GGPS4/halo/pcb/out/preview-both.png

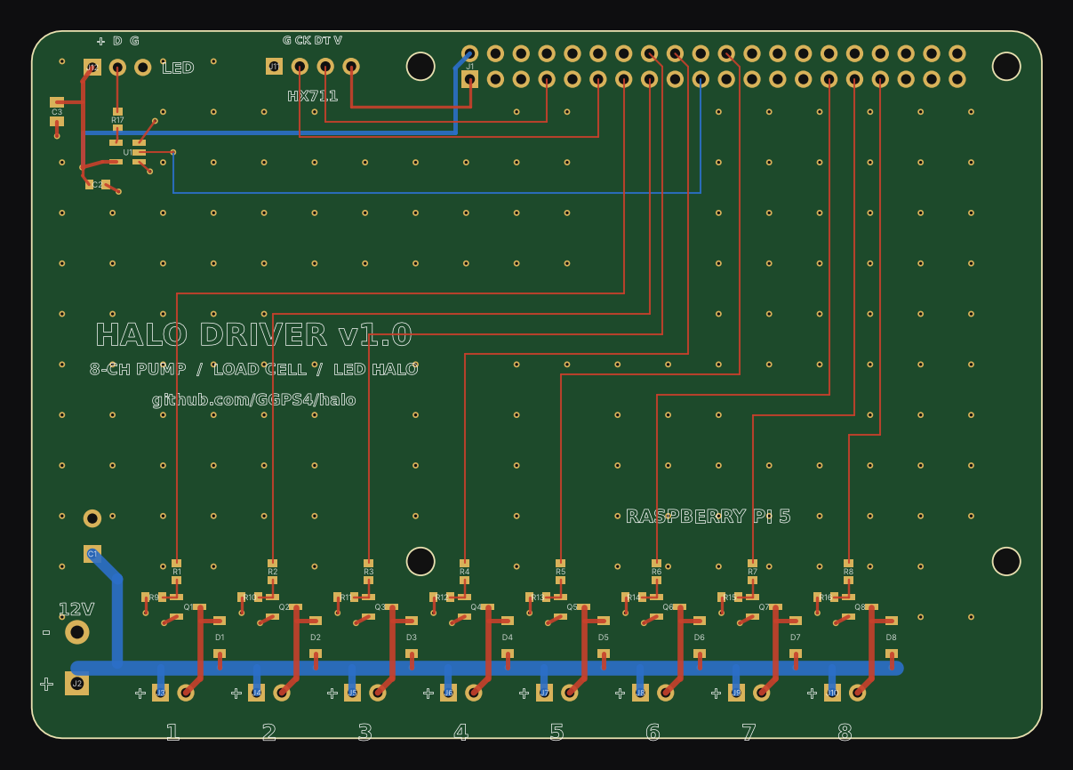
pcb/out/preview-both.png
