GGPS4/halo/pcb/out/preview-bottom.png

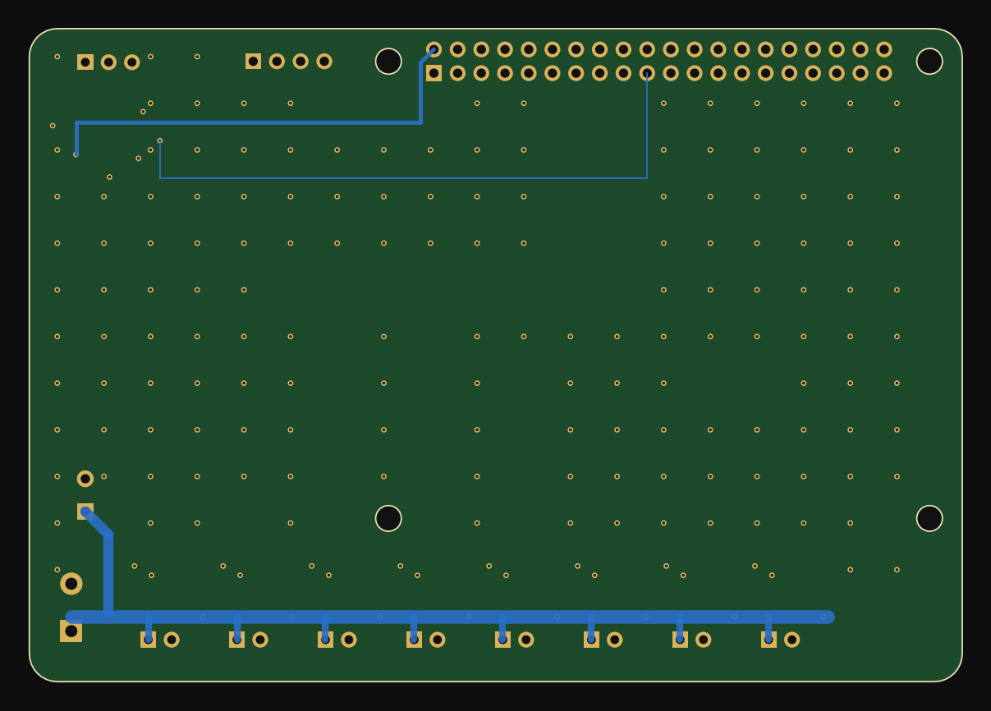
pcb/out/preview-bottom.png
