GGPS4/halo/pcb/out/halo-driver-BOM.csv

Comment | Designator | Footprint | LCSC Part #
AO3400A | Q1,Q2,Q3,Q4,Q5,Q6,Q7,Q8 | SOT-23 | C20917
B5819W | D1,D2,D3,D4,D5,D6,D7,D8 | D_SOD-123 | C8598
100 | R1,R2,R3,R4,R5,R6,R7,R8 | R_0603 | C22775
10k | R9,R10,R11,R12,R13,R14,R15,R16 | R_0603 | C25804
74AHCT1G125 | U1 | SOT-23-5 | C7484
330 | R17 | R_0603 | C23138
10uF 25V | C3 | C_0805 | C15850
100nF | C2 | C_0603 | C14663
