GGPS4/halo/pcb/out/halo-driver-hand-solder.csv

Ref | Part | Footprint
J1 | 2x20 female header | PinSocket_2x20_P2.54
J2 | 12V IN KF301-2P | TerminalBlock_5.08_1x02
C1 | 470uF 25V | CP_Radial_D8.0mm_P3.50mm
J3 | PUMP 1 JST-XH | JST_XH_B2B-XH-A
J4 | PUMP 2 JST-XH | JST_XH_B2B-XH-A
J5 | PUMP 3 JST-XH | JST_XH_B2B-XH-A
J6 | PUMP 4 JST-XH | JST_XH_B2B-XH-A
J7 | PUMP 5 JST-XH | JST_XH_B2B-XH-A
J8 | PUMP 6 JST-XH | JST_XH_B2B-XH-A
J9 | PUMP 7 JST-XH | JST_XH_B2B-XH-A
J10 | PUMP 8 JST-XH | JST_XH_B2B-XH-A
J11 | HX711 1x4 | PinHeader_1x04_P2.54
J12 | LED RING JST-XH 3P | JST_XH_B3B-XH-A
