GGPS4/halo/docs/img/wiring.png

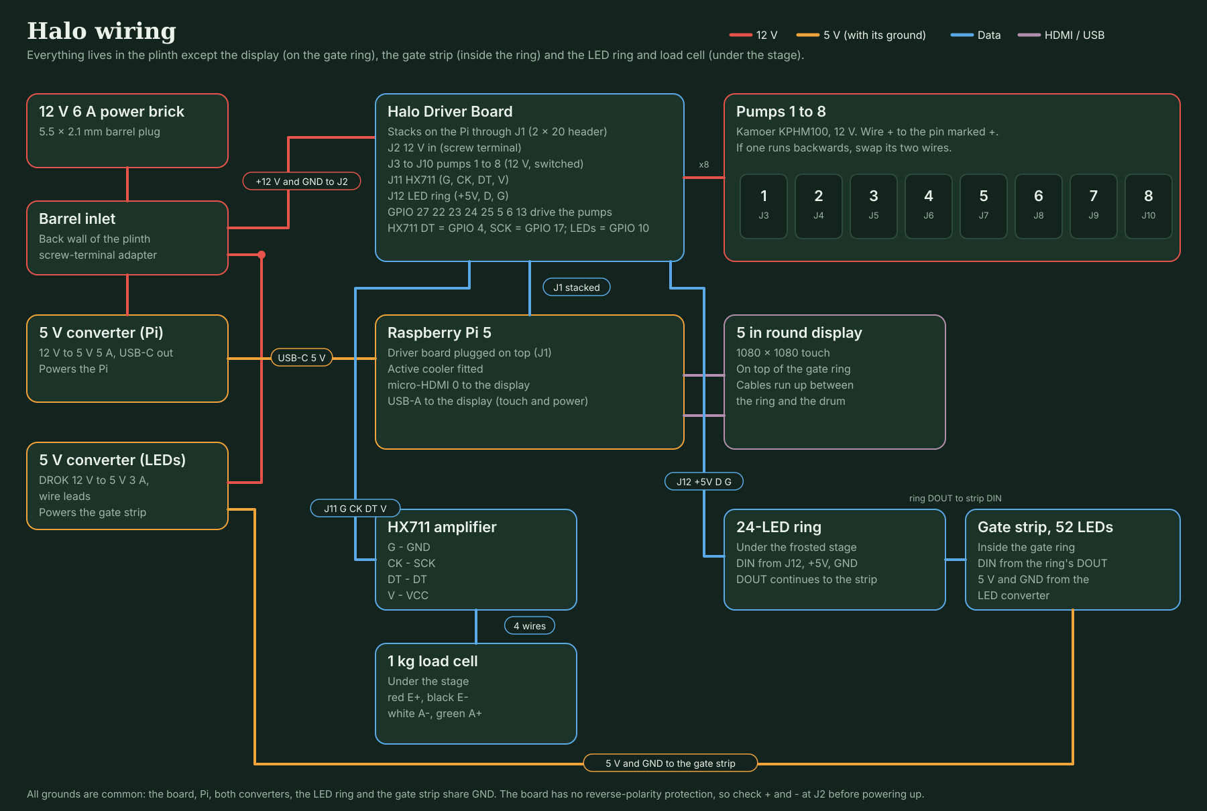
docs/img/wiring.png
