GGPS4/halo/pcb/out/halo-driver.kicad_pcb

## KiCad design pcb/out/halo-driver.kicad_pcb (2026-11-11)

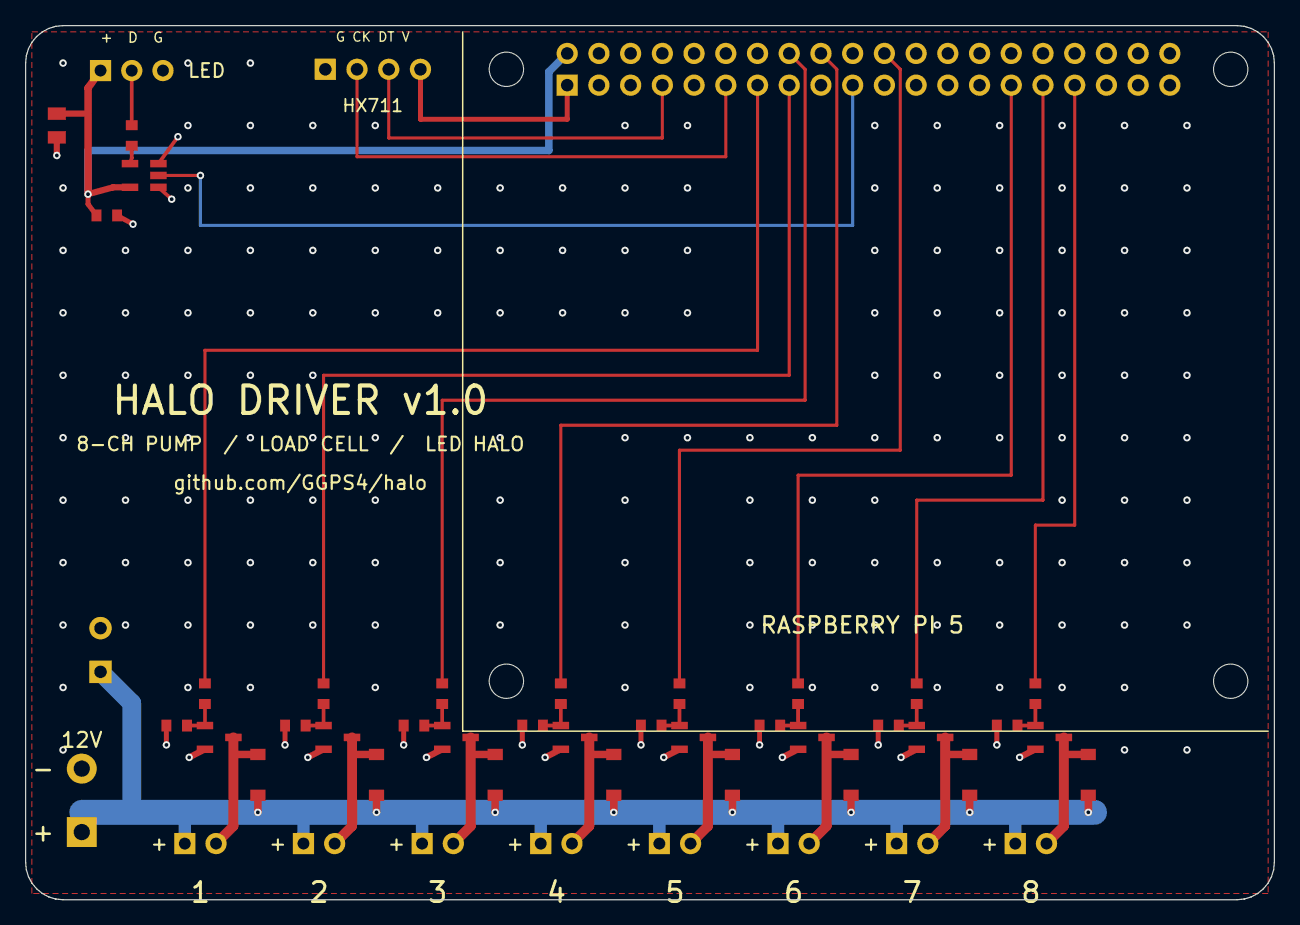
[picture p6: board halo-driver.kicad_pcb from above]

Board: 2 copper layers, 100.0 x 70.0 mm, 53 parts (0 on the bottom side), 33 nets.

Parts:
C1: 470uF 25V; CP_Radial_D8.0mm_P3.50mm
C2: 100nF; C_0603
C3: 10uF 25V; C_0805
D1, D2, D3, D4, D5, D6, D7, D8: B5819W; D_SOD-123
H1, H2, H3, H4: MountingHole_2.7mm
J1: 2x20 female header; PinSocket_2x20_P2.54
J2: 12V IN KF301-2P; TerminalBlock_5.08_1x02
J3: PUMP 1 JST-XH; JST_XH_B2B-XH-A
J4: PUMP 2 JST-XH; JST_XH_B2B-XH-A
J5: PUMP 3 JST-XH; JST_XH_B2B-XH-A
J6: PUMP 4 JST-XH; JST_XH_B2B-XH-A
J7: PUMP 5 JST-XH; JST_XH_B2B-XH-A
J8: PUMP 6 JST-XH; JST_XH_B2B-XH-A
J9: PUMP 7 JST-XH; JST_XH_B2B-XH-A
J10: PUMP 8 JST-XH; JST_XH_B2B-XH-A
J11: HX711 1x4; PinHeader_1x04_P2.54
J12: LED RING JST-XH 3P; JST_XH_B3B-XH-A
Q1, Q2, Q3, Q4, Q5, Q6, Q7, Q8: AO3400A; SOT-23
R1, R2, R3, R4, R5, R6, R7, R8: 100; R_0603
R9, R10, R11, R12, R13, R14, R15, R16: 10k; R_0603
R17: 330; R_0603
U1: 74AHCT1G125; SOT-23-5

Connections:
+3V3: J1.1, J11.4
+5V: C2.1, C3.1, J1.2, J12.1, U1.5
+12V: C1.1, D1.1, D2.1, D3.1, D4.1, D5.1, D6.1, D7.1, D8.1, J2.1, J3.1, J4.1, J5.1, J6.1, J7.1, J8.1, J9.1, J10.1
GATE1: Q1.1, R1.2, R9.2
GATE2: Q2.1, R2.2, R10.2
GATE3: Q3.1, R3.2, R11.2
GATE4: Q4.1, R4.2, R12.2
GATE5: Q5.1, R5.2, R13.2
GATE6: Q6.1, R6.2, R14.2
GATE7: Q7.1, R7.2, R15.2
GATE8: Q8.1, R8.2, R16.2
GND: C1.2, C2.2, C3.2, J1.6, J1.9, J1.14, J1.20, J1.25, J1.30, J1.34, J1.39, J2.2, J11.1, J12.3, Q1.2, Q2.2, Q3.2, Q4.2, Q5.2, Q6.2, Q7.2, Q8.2, R9.1, R10.1, R11.1, R12.1, R13.1, R14.1, R15.1, R16.1, U1.1, U1.3
GPIO_P1: J1.13, R1.1
GPIO_P2: J1.15, R2.1
GPIO_P3: J1.16, R3.1
GPIO_P4: J1.18, R4.1
GPIO_P5: J1.22, R5.1
GPIO_P6: J1.29, R6.1
GPIO_P7: J1.31, R7.1
GPIO_P8: J1.33, R8.1
HX_DT: J1.7, J11.3
HX_SCK: J1.11, J11.2
LED_DIN: J1.19, U1.2
LED_DOUT: J12.2, R17.1
LED_Y: R17.2, U1.4
PUMP1-: D1.2, J3.2, Q1.3
PUMP2-: D2.2, J4.2, Q2.3
PUMP3-: D3.2, J5.2, Q3.3
PUMP4-: D4.2, J6.2, Q4.3
PUMP5-: D5.2, J7.2, Q5.3
PUMP6-: D6.2, J8.2, Q6.3
PUMP7-: D7.2, J9.2, Q7.3
PUMP8-: D8.2, J10.2, Q8.3
