GGPS4/halo/(commit log)

2026-11-11 Halo: AI cocktail maker that pours by weight
    Original design: pour-by-weight engine with glass detection and empty-bottle
    stall detection, Claude bartender, round touchscreen UI, phone setup page and
    local API, plus the Halo Driver Board (Gerbers, JLCPCB BOM/CPL, KiCad board).
    Claude-Session: https://claude.ai/code/session_01QvFes5Qa3sPgAK3sVLZrHc
    [halo-driver-BOM.csv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]
2026-11-11 Add Fusion API script that builds the full Halo assembly
    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
2026-11-11 Add Fusion finishing script: physical materials and appearances for every part, drip tray
    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
2026-11-11 Gate redesign: sealed plinth, upright light ring, hidden bottle drum
    Adds cad/build_gate.py (builds Halo Gate Assembly in Fusion), a render,
    and updates the README and design spec for the new form.
    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
2026-11-11 Light strip inside the gate ring, chained after the LED ring
    The strip mirrors the ring's pattern from both feet to the top, so a pour
    climbs the gate. Adds hardware.gate_led_count (default 52) and a test.
    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
2026-11-11 Web app demo for GitHub Pages; Gate layout on the bottle map
    halo/web/demo.js answers the API in the browser with sample data when the app
    is opened on github.io or with ?demo, so it can be tried without hardware.
    Built by scripts/build_demo.py and published by scripts/publish_demo.sh.
    Also: relative asset paths, live step text during a pour, and a top-down
    bottle map that matches the Gate drum.
    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
2026-11-11 Gate ring: channel for the LED strip; docs
    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
2026-11-11 Pumps learn their own stopping point; drinks sized for a cup of ice
    - PumpLearning: per-pump flow and post-stop landing learned from the scale,
    used as each pump's stop-early amount; worn-tubing warning; /api/pumps
    - Sizes by alcohol (pour_oz of 40% spirit per single) capped by cup_ml,
    so drinks are ready to drink poured over ice
    - Pour lightest first so syrups and juices mix on the way down
    - Bartender brief: built-over-ice drinks, nothing that needs shaking
    - Web app: per-drink sizes, cup and spirit settings, Pumps on Stats,
    tubing notices; demo updated
    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
2026-11-11 Ready glow until picked up, weight guard, self-clean, setup check, recipe library
    - Feature 3: finished drinks stay lit until the cup is lifted; no pouring into a
    drink still on the stage; scale re-zeroes on pickup
    - Feature 13: stop on weight surges, a tipped cup, or a pump that won't switch off
    - Self-clean from the web app: soapy pass, soak, rinses, air purge, catch-cup
    emptying, re-prime
    - Setup check: scale check and one-tap fix, light test, prime and time each pump
    - Library: classics from TheCocktailDB matched to your bottles, add or adapt
    - Demo backend simulates all of the above
    Claude-Session: https://claude.ai/code/sessi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
    [__main__.py, config.py, hardware.py, maintenance.py, pour.py, server.py]
2026-11-11 Fusion: Halo Gate folder with linked part files and assembly
    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
2026-11-11 Quieter pumps, thick-liquid handling, undo, wiring diagram
    - Feature 12: pumps ease up to speed (0.4 s soft start); PWM raised from
    200 Hz to 10 kHz (lgpio's software maximum), configurable
    - Feature 13: per-pump slow-zone profile: syrups and slow or inaccurate pumps
    start slowing earlier and finish gentler
    - Feature 10: 10-second Undo for every bottle, drink, party and settings change
    - Feature 4: docs/img/wiring.svg/.png drawn by scripts/wiring_diagram.py; the
    gate strip gets its own 5 V converter
    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
2026-11-12 Print-ready parts, ring/load-cell fix, printing guide
    cad/print_parts.py splits every printed part to fit a 220 mm bed with pin holes,
    inserts and screw holes; adds the electronics tray and tube clips. cad/fix_ring.py
    updates the assembly. cad/turntable.py renders README frames.
    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
2026-11-12 printing.md: match the build guide's assembly order
    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
